InvncibiltyCloak/ESPMaslowController/README.md

# ESPMaslowController
Upgrade of the Maslow CNC controller based on the ESP32 microcontroller.

The design files are for KiCAD.

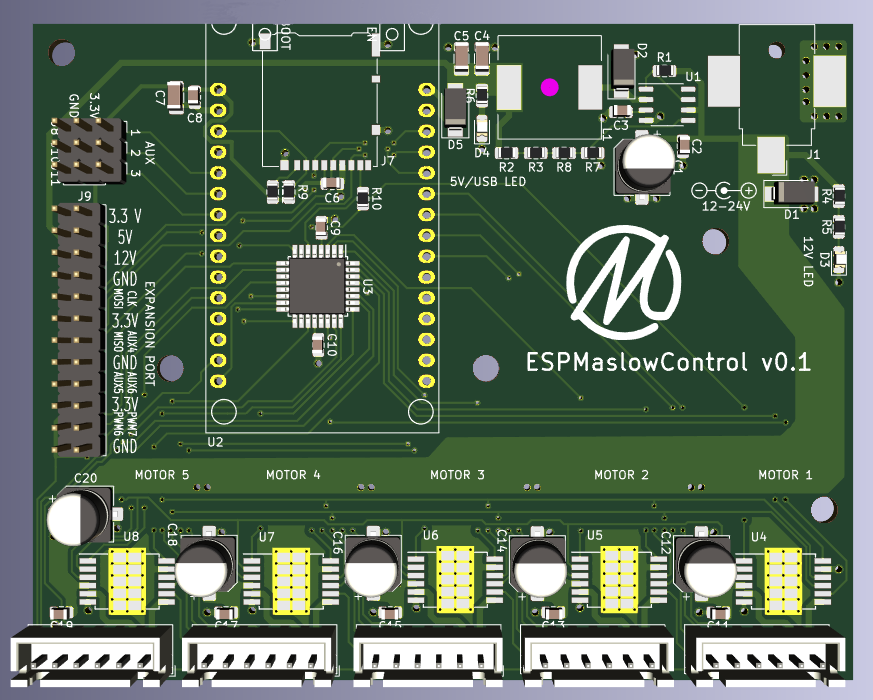
[picture p1: docs/board_render.png]
A rendering of the PCB
