InvncibiltyCloak/ESPMaslowController/ESPMaslowController.pdf

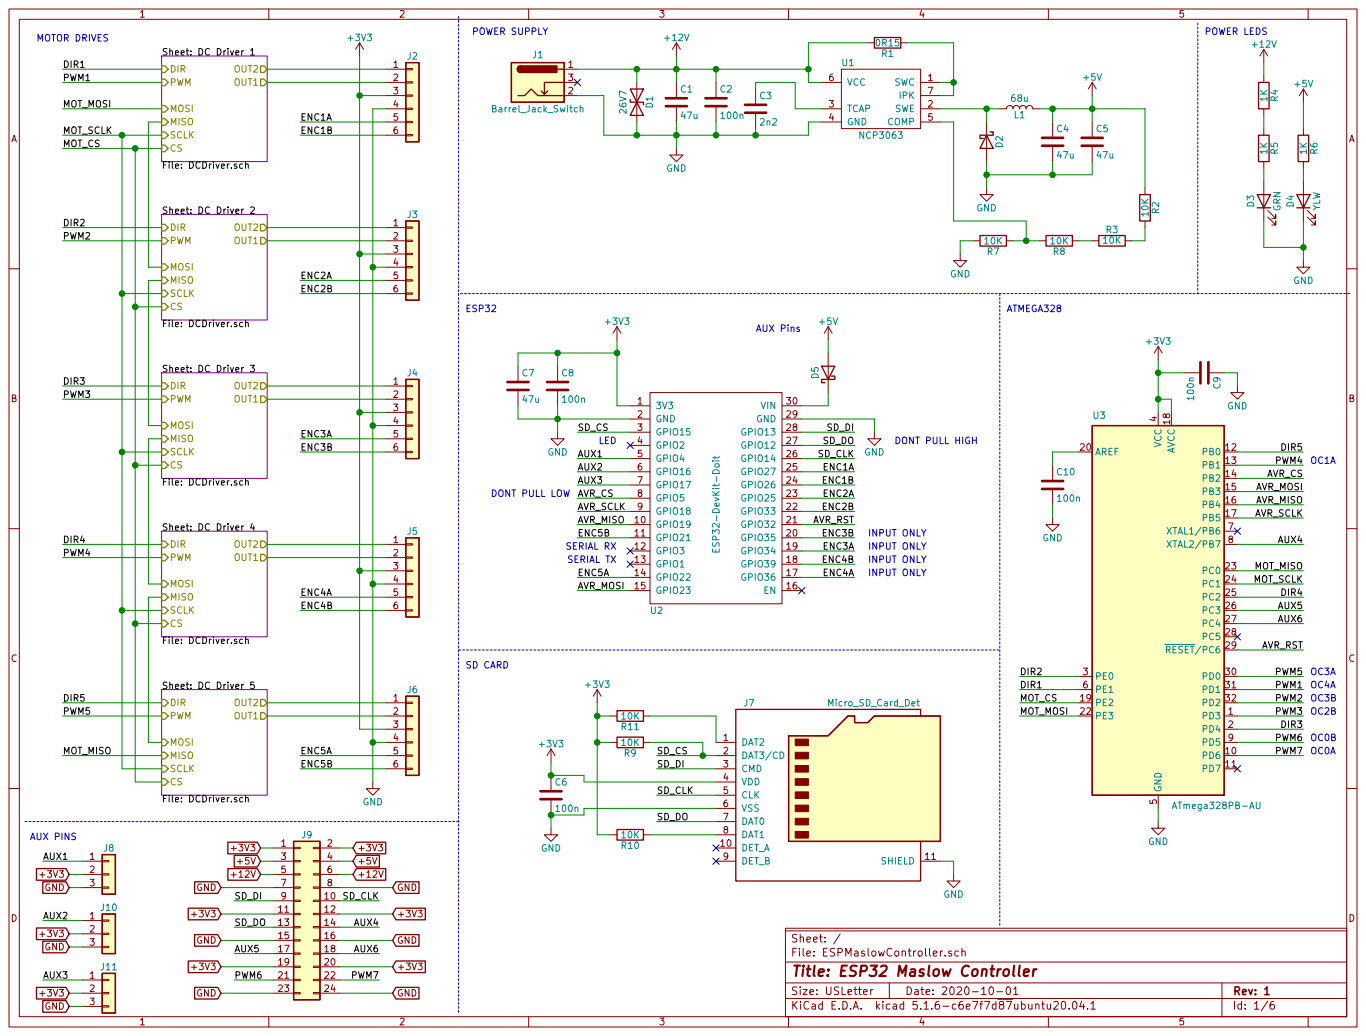
[picture p2: page 1]

Sheet: DC Driver 1 File: DCDriver.sch DIR

Sheet: DC Driver 2 File: DCDriver.sch DIR

Sheet: DC Driver 3 File: DCDriver.sch DIR

INPUT ONLY DONT PULL LOW

Sheet: DC Driver 4 File: DCDriver.sch DIR

Id: 1/6 Title: ESP32 Maslow Controller File: ESPMaslowController.sch Sheet: / Sheet: DC Driver 5 File: DCDriver.sch DIR

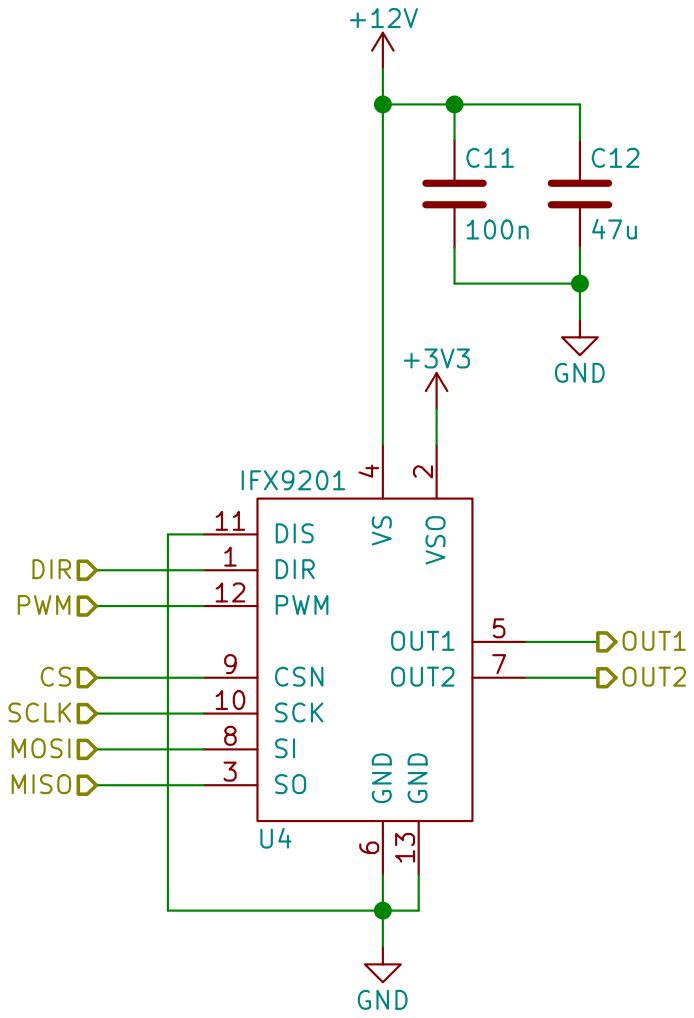
[picture p3: page 2]

Id: 2/6 Title: File: DCDriver.sch Sheet: /DC Driver 1/

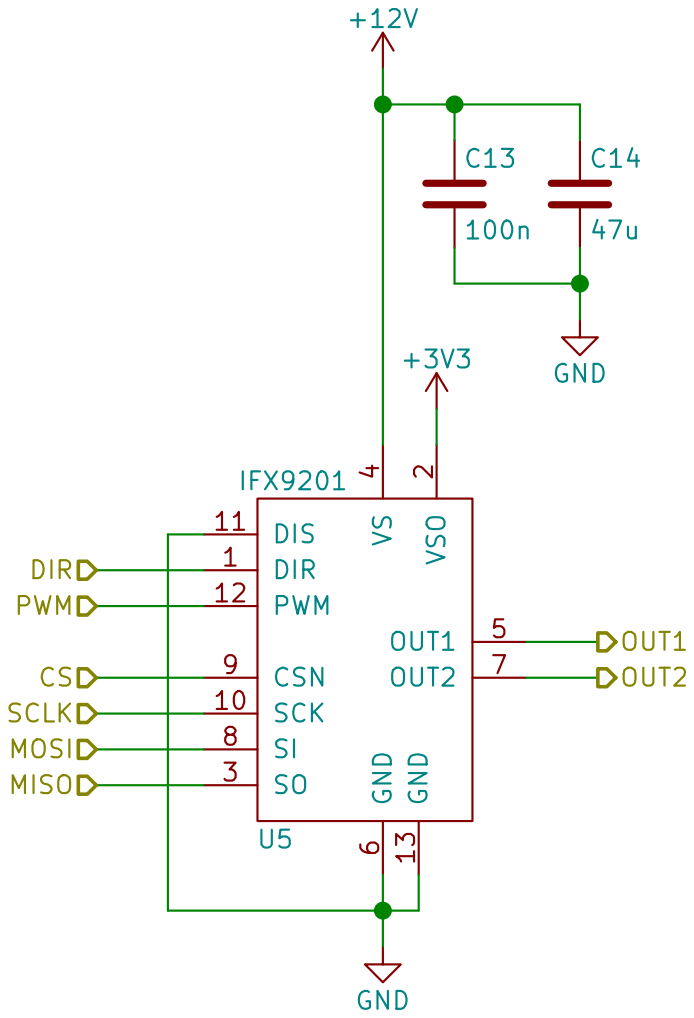
[picture p4: page 3]

Id: 3/6 Title: File: DCDriver.sch Sheet: /DC Driver 2/

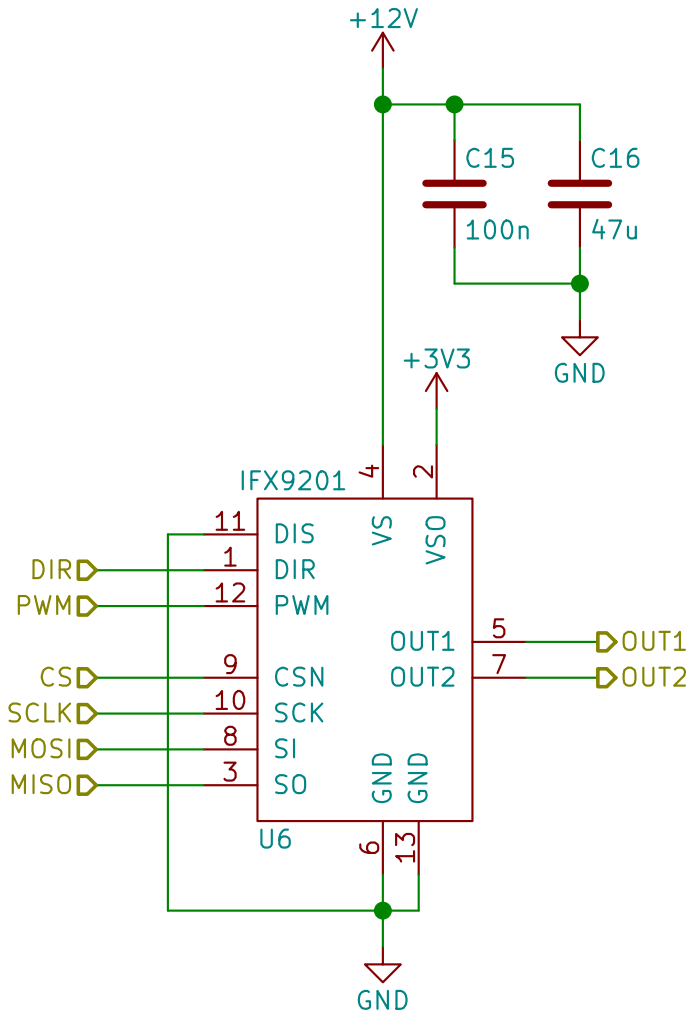
[picture p5: page 4]

Id: 4/6 Title: File: DCDriver.sch Sheet: /DC Driver 3/

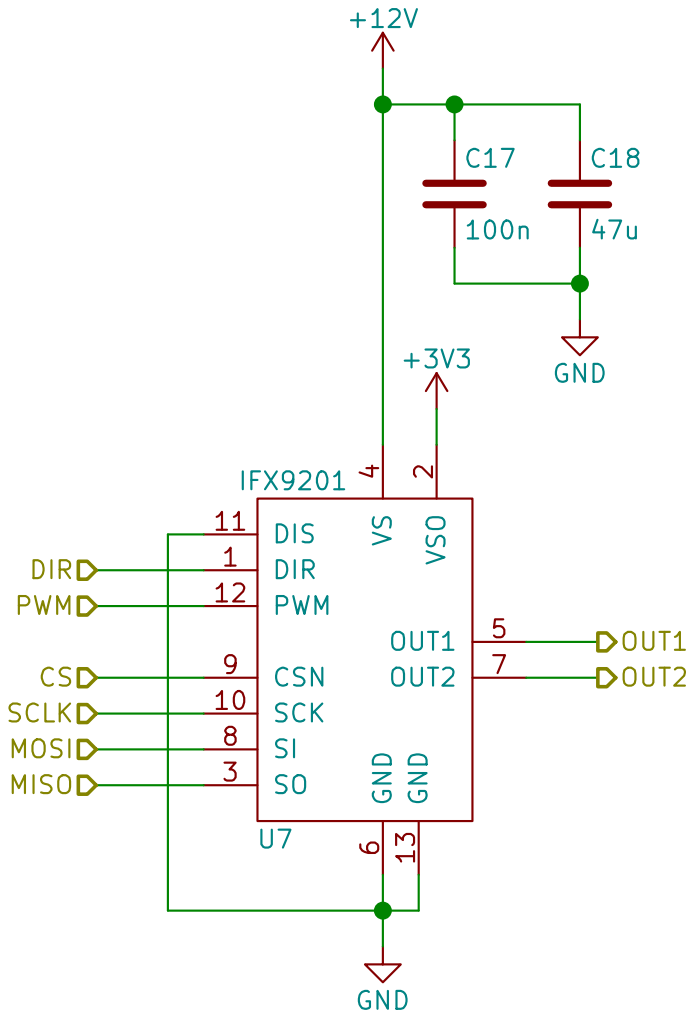
[picture p6: page 5]

Id: 5/6 Title: File: DCDriver.sch Sheet: /DC Driver 4/

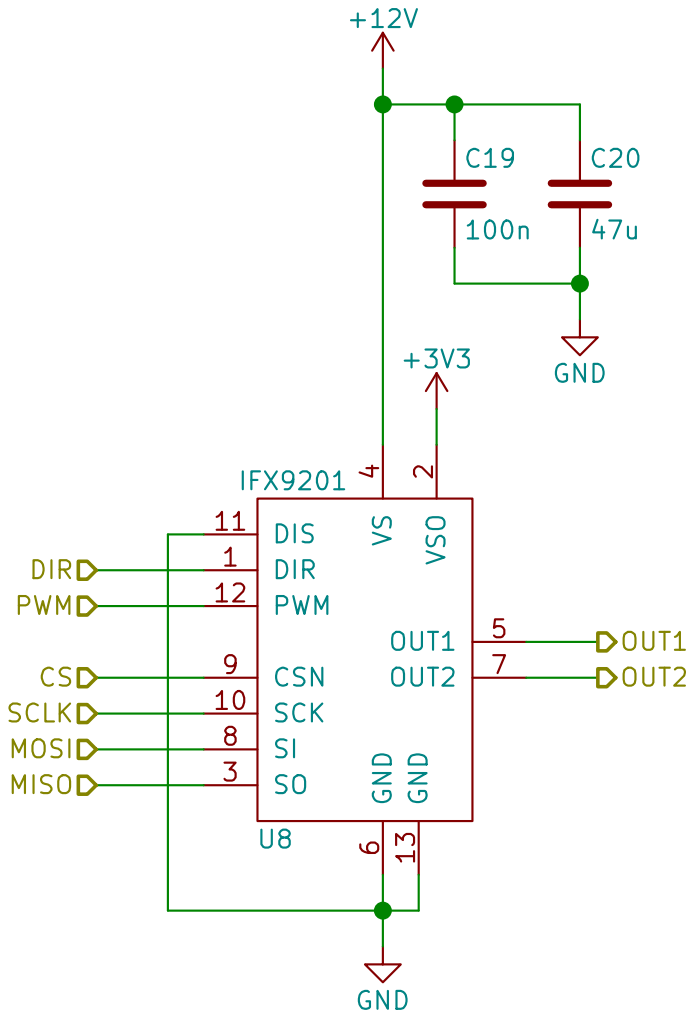
[picture p7: page 6]

Id: 6/6 Title: File: DCDriver.sch Sheet: /DC Driver 5/
