InvncibiltyCloak/ESPMaslowController/ESPMaslowController.kicad_pcb

## KiCad design ESPMaslowController.kicad_pcb (2020-12-19)

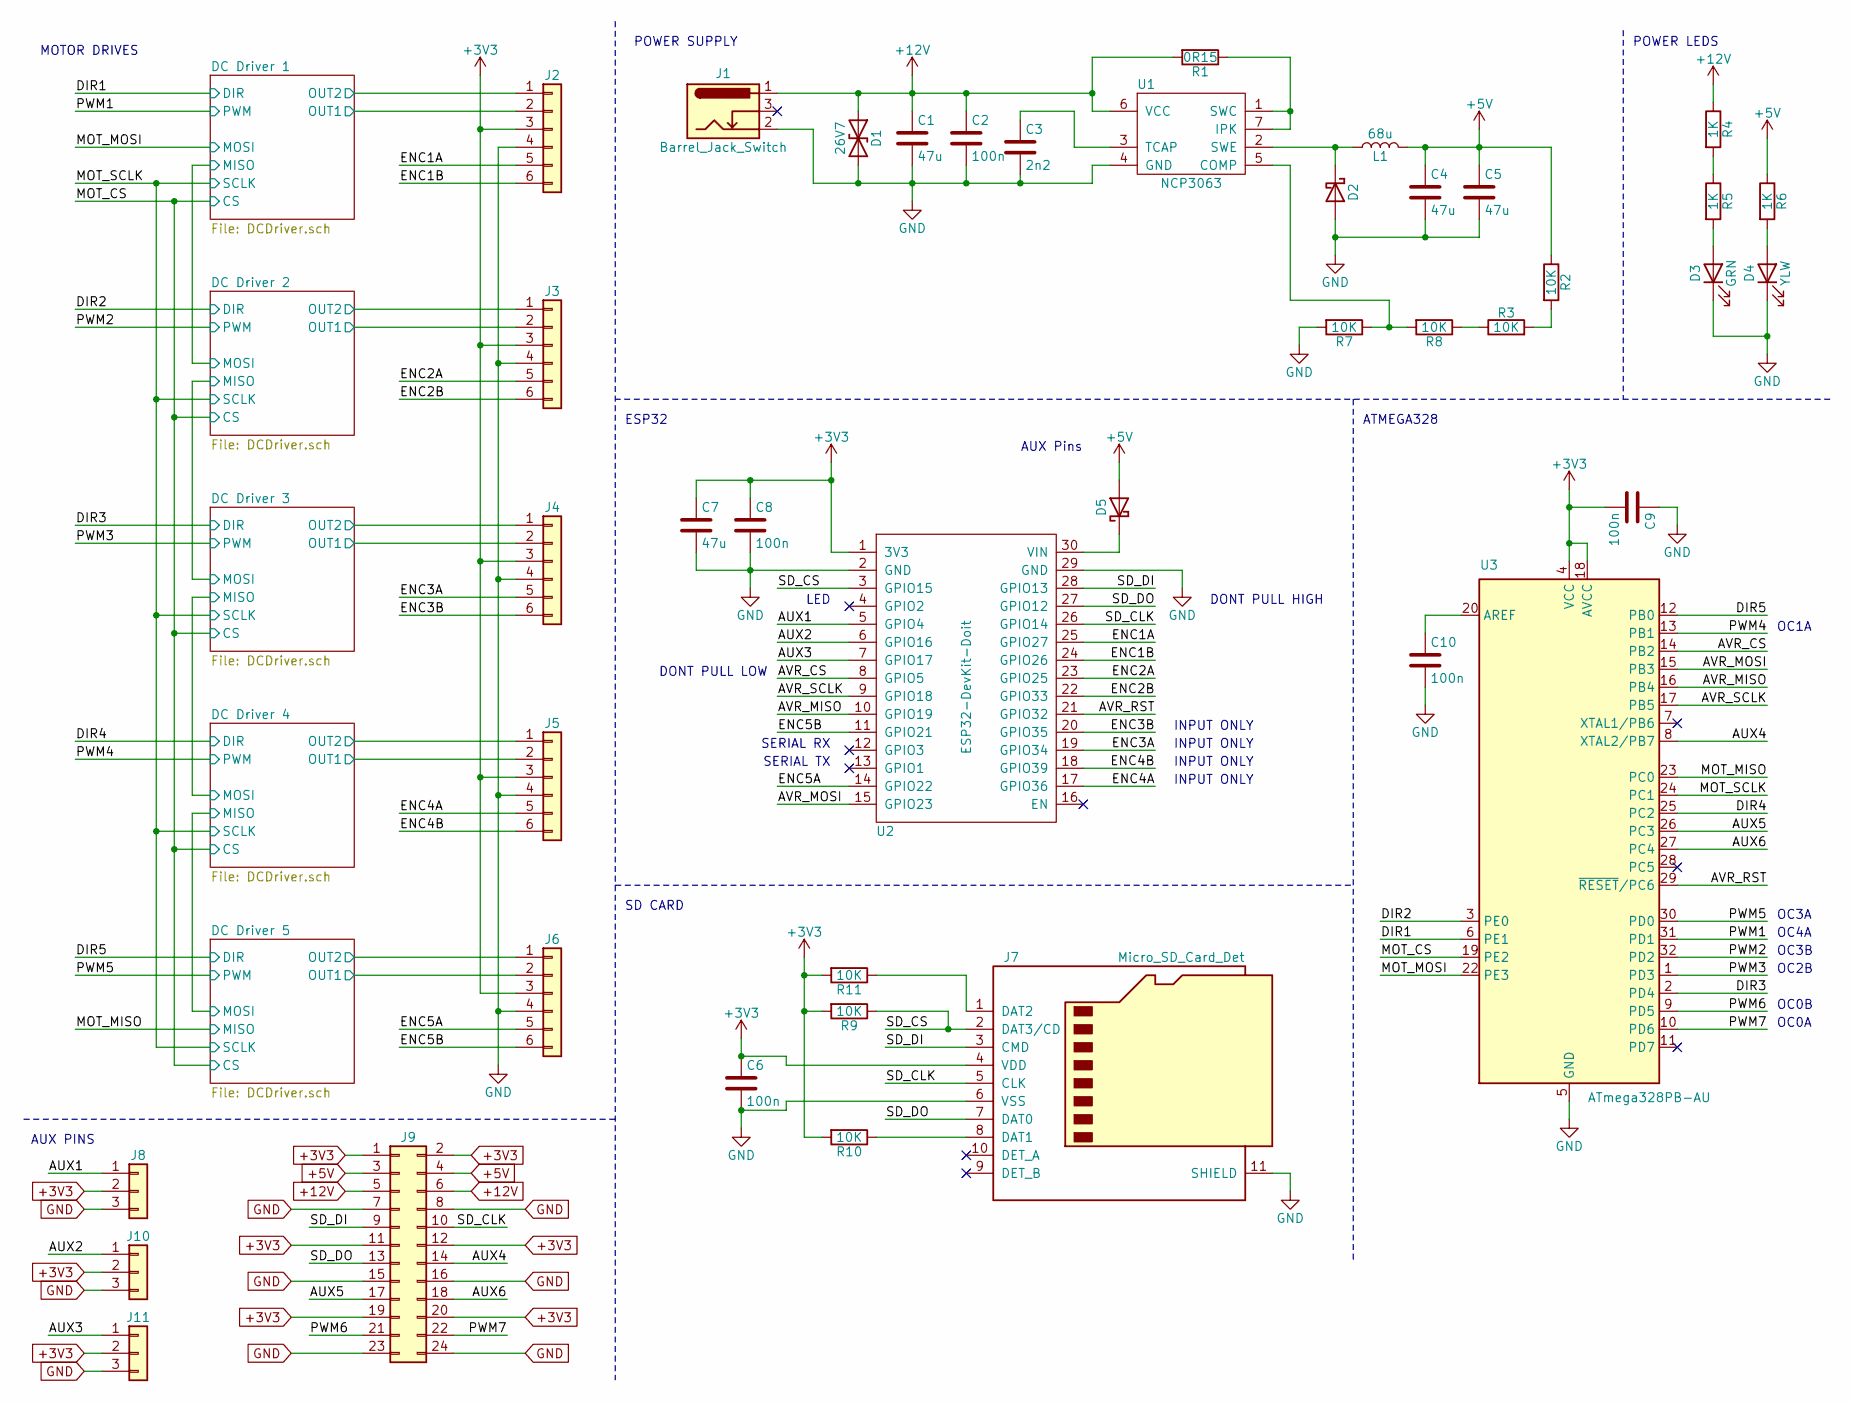
[picture p8: schematic ESPMaslowController.sch, ESP32 Maslow Controller]

Parts:
C1: 47u; CP_Elec_6.3x5.9; MPN 35SVPK47M
C2, C6, C8, C9, C10: 100n; C_0805_2012Metric; MPN CC0805KRX7R9BB104; LCSC C49678
C3: 2n2; C_0805_2012Metric; MPN CL21B222KBANNNC; LCSC C28260
C4, C5, C7: 47u; C_1206_3216Metric; MPN CL31A476MQHNNNE; LCSC C96123
D1: 26V7; D_SMA; MPN SMAJ24CA
D2, D5: 2A; D_SMA; MPN STPS2L30A
D3: GRN; LED_0805_2012Metric_Castellated; MPN LTST-C170KGKT; LCSC C2297
D4: YLW; LED_0805_2012Metric_Castellated; MPN LTST-C171KSKT; LCSC C2296
J1: Barrel_Jack_Switch; BarrelJack_CUI_PJ-036AH-SMT_Horizontal; MPN PJ-036AH-SMT-TR
J2, J3, J4, J5, J6: B6B-XH-A; JST_XH_B6B-XH-A_1x06_P2.50mm_Vertical; MPN B6B-PH-K-S(LF)(SN)
J7: Micro_SD_Card_Det; microSD_HC_Hirose_DM3AT-SF-PEJM5; MPN DM3AT-SF-PEJM5
J8, J10, J11: Conn_01x03; PinHeader_1x03_P2.54mm_Vertical; MPN G800W305018EU
J9: Conn_02x12_Odd_Even; PinHeader_2x12_P2.54mm_Vertical; MPN G800W590018EU
L1: 68u; L_12x12mm_H8mm; MPN NS12575T680MN
R1: 0R15; R_0805_2012Metric; MPN KDV08FR150ET
R2, R3, R7, R8, R9, R10, R11: 10K; R_0805_2012Metric; MPN RC0805FR-0710KL; LCSC C17414
R4, R5, R6: 1K; R_0805_2012Metric; MPN RC0805FR-071KL; LCSC C17513
U1: NCP3063; SO-8_3.9x4.9mm_P1.27mm; MPN NCP3063BDR2G
U2: ESP32-DevKit-Doit; ESP32-DEVKIT-V1; MPN ESP32 DevKit v1
U3: ATmega328PB-AU; TQFP-32_7x7mm_P0.8mm; MPN ATMEGA328PB-AU

Connections:
+3V3: C6.1, C7.1, C8.1, C9.2, J2.3, J3.3, J4.3, J5.3, J6.3, J7.4 (VDD), J8.2, J9.1, J9.2, J9.11, J9.12, J9.19, J9.20, J10.2, J11.2, R9.2, R10.2, R11.2, U2.1 (3V3), U3.4 (VCC), U3.18 (AVCC); also elsewhere on the board
+5V: C4.1, C5.1, D5.2 (A), J9.3, J9.4, L1.1, R2.1, R6.1
+12V: C1.1, C2.1, D1.1 (A1), J1.1, J9.5, J9.6, R1.2, R4.1, U1.6 (VCC); also elsewhere on the board
/AUX1: J8.1, U2.5 (GPIO4)
/AUX2: J10.1, U2.6 (GPIO16)
/AUX3: J11.1, U2.7 (GPIO17)
/AUX4: J9.14, U3.8 (XTAL2/PB7)
/AUX5: J9.17, U3.26 (PC3)
/AUX6: J9.18, U3.27 (PC4)
/AVR_CS: U2.8 (GPIO5), U3.14 (PB2)
/AVR_MISO: U2.10 (GPIO19), U3.16 (PB4)
/AVR_MOSI: U2.15 (GPIO23), U3.15 (PB3)
/AVR_RST: U2.21 (GPIO32), U3.29 (~RESET~/PC6)
/AVR_SCLK: U2.9 (GPIO18), U3.17 (PB5)
/DC Driver 1/OUT1: J2.2; also elsewhere on the board
/DC Driver 1/OUT2: J2.1; also elsewhere on the board
/DC Driver 2/OUT1: J3.2; also elsewhere on the board
/DC Driver 2/OUT2: J3.1; also elsewhere on the board
/DC Driver 3/OUT1: J4.2; also elsewhere on the board
/DC Driver 3/OUT2: J4.1; also elsewhere on the board
/DC Driver 4/OUT1: J5.2; also elsewhere on the board
/DC Driver 4/OUT2: J5.1; also elsewhere on the board
/DC Driver 5/OUT1: J6.2; also elsewhere on the board
/DC Driver 5/OUT2: J6.1; also elsewhere on the board
/DIR1: U3.6 (PE1); also elsewhere on the board
/DIR2: U3.3 (PE0); also elsewhere on the board
/DIR3: U3.2 (PD4); also elsewhere on the board
/DIR4: U3.25 (PC2); also elsewhere on the board
/DIR5: U3.12 (PB0); also elsewhere on the board
/ENC1A: J2.5, U2.25 (GPIO27)
/ENC1B: J2.6, U2.24 (GPIO26)
/ENC2A: J3.5, U2.23 (GPIO25)
/ENC2B: J3.6, U2.22 (GPIO33)
/ENC3A: J4.5, U2.19 (GPIO34)
/ENC3B: J4.6, U2.20 (GPIO35)
/ENC4A: J5.5, U2.17 (GPIO36)
/ENC4B: J5.6, U2.18 (GPIO39)
/ENC5A: J6.5, U2.14 (GPIO22)
/ENC5B: J6.6, U2.11 (GPIO21)
/MOT_CS: U3.19 (PE2); also elsewhere on the board
/MOT_MISO: U3.23 (PC0); also elsewhere on the board
/MOT_MOSI: U3.22 (PE3); also elsewhere on the board
/MOT_SCLK: U3.24 (PC1); also elsewhere on the board
/PWM1: U3.31 (PD1); also elsewhere on the board
/PWM2: U3.32 (PD2); also elsewhere on the board
/PWM3: U3.1 (PD3); also elsewhere on the board
/PWM4: U3.13 (PB1); also elsewhere on the board
/PWM5: U3.30 (PD0); also elsewhere on the board
/PWM6: J9.21, U3.9 (PD5)
/PWM7: J9.22, U3.10 (PD6)
/SD_CLK: J7.5 (CLK), J9.10, U2.26 (GPIO14)
/SD_CS: J7.2 (DAT3/CD), R9.1, U2.3 (GPIO15)
/SD_DI: J7.3 (CMD), J9.9, U2.28 (GPIO13)
/SD_DO: J7.7 (DAT0), J9.13, U2.27 (GPIO12)
GND: C1.2, C2.2, C3.2, C4.2, C5.2, C6.2, C7.2, C8.2, C9.1, C10.2, D1.2 (A2), D2.2 (A), D3.1 (K), D4.1 (K), J1.2, J2.4, J3.4, J4.4, J5.4, J6.4, J7.6 (VSS), J7.11 (SHIELD), J8.3, J9.7, J9.8, J9.15, J9.16, J9.23, J9.24, J10.3, J11.3, R7.2, U1.4 (GND), U2.2 (GND), U2.29 (GND), U3.5 (GND), U3.21 (GND); also elsewhere on the board
unnamed: C3.1, U1.3 (TCAP)
unnamed: C10.1, U3.20 (AREF)
unnamed: D2.1 (K), L1.2, U1.2 (SWE)
unnamed: D3.2 (A), R5.2
unnamed: D4.2 (A), R6.2
unnamed: D5.1 (K), U2.30 (VIN)
unnamed: J7.1 (DAT2), R11.1
unnamed: J7.8 (DAT1), R10.1
unnamed: R1.1, U1.1 (SWC), U1.7 (IPK)
unnamed: R2.2, R3.2
unnamed: R3.1, R8.1
unnamed: R4.2, R5.1
unnamed: R7.1, R8.2, U1.5 (COMP)

Notes on the sheet:
AUX Pins
SERIAL TX
DONT PULL LOW
INPUT ONLY
SERIAL RX
LED
DONT PULL HIGH
AUX PINS
MOTOR DRIVES
POWER SUPPLY
POWER LEDS
ESP32
ATMEGA328
SD CARD
OC2B
OC0B
OC0A
OC1A
OC3A
OC4A
OC3B

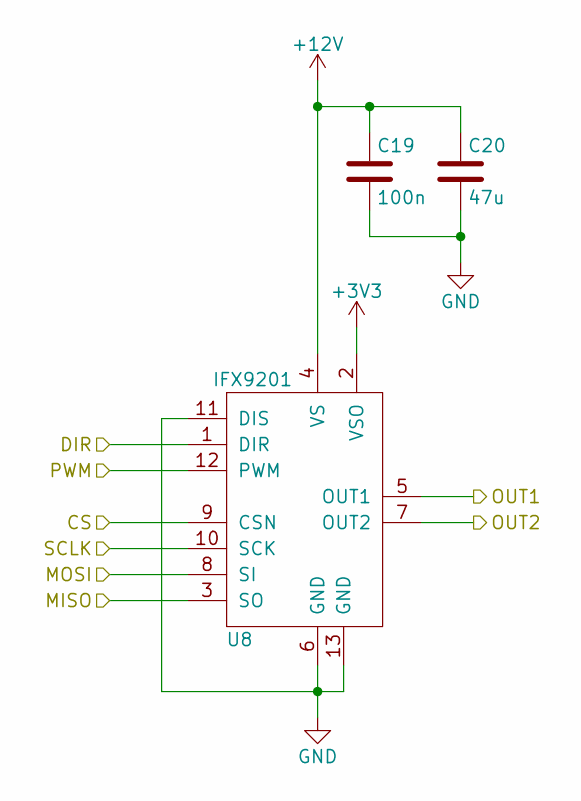
[picture p9: schematic DCDriver.sch]

Parts:
C11: 100n; C_0805_2012Metric; MPN CC0805KRX7R9BB104; LCSC C49678
C12: 47u; CP_Elec_6.3x5.9; MPN 35SVPK47M
U4: IFX9201; Infineon_PG-DSO-12-9_ThermalVias; MPN IFX9201SGAUMA1; LCSC C112633

Connections:
+3V3: U4.2 (VSO); also elsewhere on the board
+12V: C11.1, C12.1, U4.4 (VS); also elsewhere on the board
/DC Driver 1/MISO: U4.3 (SO); also elsewhere on the board
/DC Driver 1/OUT1: U4.5 (OUT1); also elsewhere on the board
/DC Driver 1/OUT2: U4.7 (OUT2); also elsewhere on the board
/DIR1: U4.1 (DIR); also elsewhere on the board
/MOT_CS: U4.9 (CSN); also elsewhere on the board
/MOT_MOSI: U4.8 (SI); also elsewhere on the board
/MOT_SCLK: U4.10 (SCK); also elsewhere on the board
/PWM1: U4.12 (PWM); also elsewhere on the board
GND: C11.2, C12.2, U4.6 (GND), U4.11 (DIS), U4.13 (GND); also elsewhere on the board

Parts of its further copies:
C13, C15, C17, C19: 100n; C_0805_2012Metric; MPN CC0805KRX7R9BB104; LCSC C49678
C14, C16, C18, C20: 47u; CP_Elec_6.3x5.9; MPN 35SVPK47M
U5, U6, U7, U8: IFX9201; Infineon_PG-DSO-12-9_ThermalVias; MPN IFX9201SGAUMA1; LCSC C112633

Connections of its further copies:
+3V3: U5.2 (VSO), U6.2 (VSO), U7.2 (VSO), U8.2 (VSO); also elsewhere on the board
+12V: C13.1, C14.1, C15.1, C16.1, C17.1, C18.1, C19.1, C20.1, U5.4 (VS), U6.4 (VS), U7.4 (VS), U8.4 (VS); also elsewhere on the board
/DC Driver 1/MISO: U5.8 (SI); also elsewhere on the board
/DC Driver 2/MISO: U5.3 (SO), U6.8 (SI)
/DC Driver 2/OUT1: U5.5 (OUT1); also elsewhere on the board
/DC Driver 2/OUT2: U5.7 (OUT2); also elsewhere on the board
/DC Driver 3/MISO: U6.3 (SO), U7.8 (SI)
/DC Driver 3/OUT1: U6.5 (OUT1); also elsewhere on the board
/DC Driver 3/OUT2: U6.7 (OUT2); also elsewhere on the board
/DC Driver 4/MISO: U7.3 (SO), U8.8 (SI)
/DC Driver 4/OUT1: U7.5 (OUT1); also elsewhere on the board
/DC Driver 4/OUT2: U7.7 (OUT2); also elsewhere on the board
/DC Driver 5/OUT1: U8.5 (OUT1); also elsewhere on the board
/DC Driver 5/OUT2: U8.7 (OUT2); also elsewhere on the board
/DIR2: U5.1 (DIR); also elsewhere on the board
/DIR3: U6.1 (DIR); also elsewhere on the board
/DIR4: U7.1 (DIR); also elsewhere on the board
/DIR5: U8.1 (DIR); also elsewhere on the board
/MOT_CS: U5.9 (CSN), U6.9 (CSN), U7.9 (CSN), U8.9 (CSN); also elsewhere on the board
/MOT_MISO: U8.3 (SO); also elsewhere on the board
/MOT_SCLK: U5.10 (SCK), U6.10 (SCK), U7.10 (SCK), U8.10 (SCK); also elsewhere on the board
/PWM2: U5.12 (PWM); also elsewhere on the board
/PWM3: U6.12 (PWM); also elsewhere on the board
/PWM4: U7.12 (PWM); also elsewhere on the board
/PWM5: U8.12 (PWM); also elsewhere on the board
GND: C13.2, C14.2, C15.2, C16.2, C17.2, C18.2, C19.2, C20.2, U5.6 (GND), U5.11 (DIS), U5.13 (GND), U6.6 (GND), U6.11 (DIS), U6.13 (GND), U7.6 (GND), U7.11 (DIS), U7.13 (GND), U8.6 (GND), U8.11 (DIS), U8.13 (GND); also elsewhere on the board

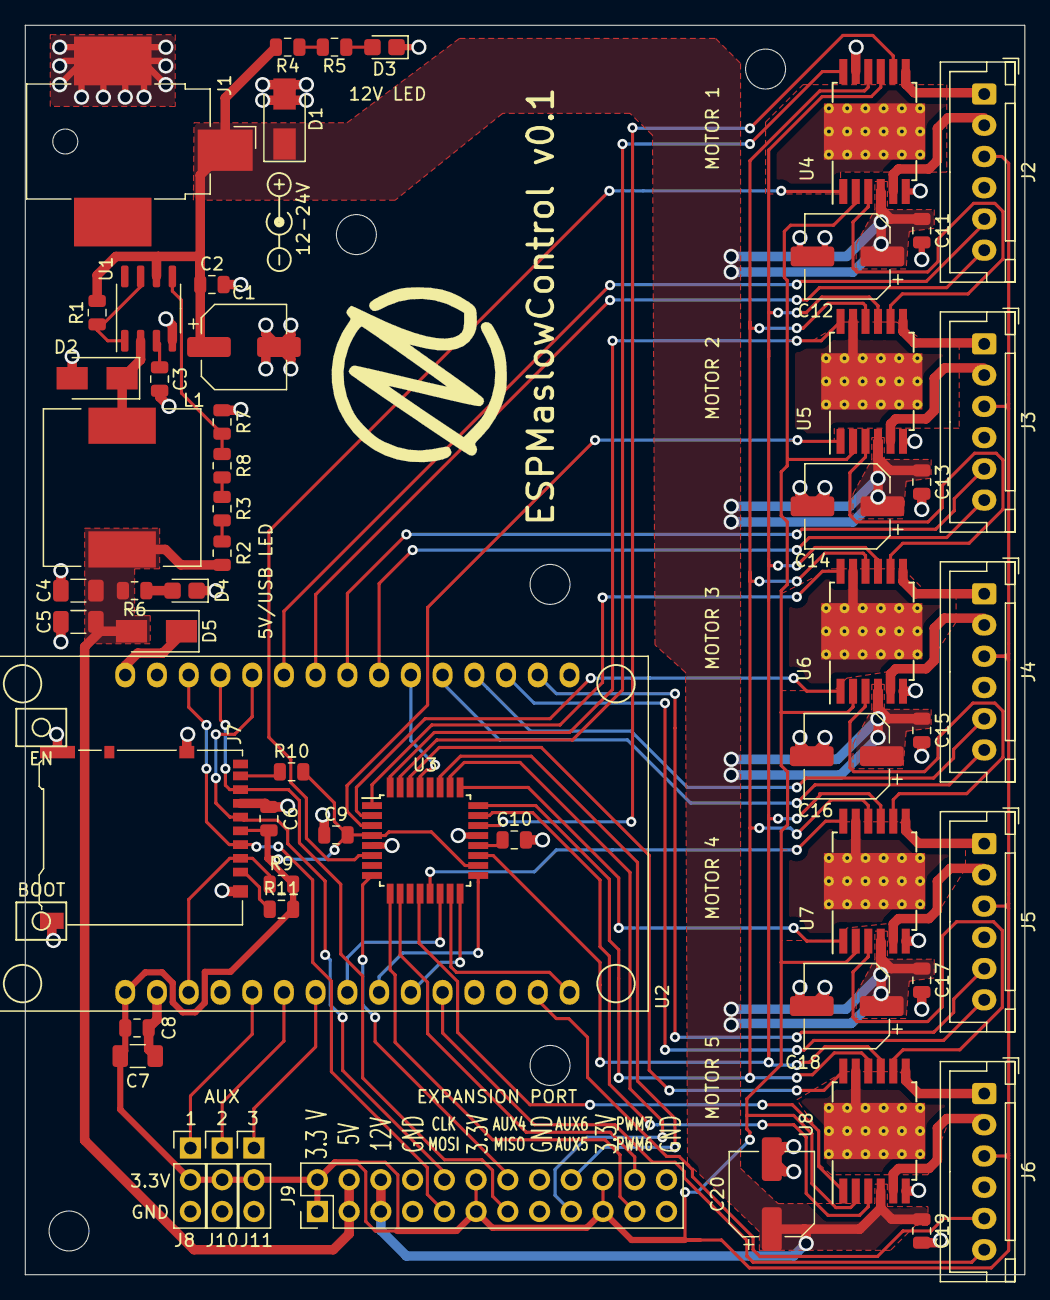
[picture p10: board ESPMaslowController.kicad_pcb from above]

Board: 2 copper layers, 80.0 x 100.0 mm, 56 parts (0 on the bottom side), 72 nets.
