InvncibiltyCloak/ESPMaslowController/(commit log)

2020-10-02 First revision of schematic complete.
    [DCDriver.sch, ESPMaslowController.sch]
2020-10-03 Moved PWM outputs to OC pins on ATmega328.
    The original plan was to do a software PWM on Port D. Testing showed frequencies of only 450 Hz could be achieved at 100% CPU usage. This is too low to be useful, and was not phase-correct PWM.
    [DCDriver.sch, ESPMaslowController.sch]
2020-10-04 Finalized BOM and reworked AUX pins.
    [DCDriver.sch, ESPMaslowController.sch]
2020-10-04 Created footprint for ESP32.
    [DCDriver.sch, ESPMaslowController.sch]
2020-10-08 Revision v0.1 of PCB fully complete.
    [DCDriver.sch, ESPMaslowController.kicad_pcb, ESPMaslowController.sch]
2020-10-09 Updated LCSC references to match ordered parts.
    [DCDriver.sch, ESPMaslowController.sch]
2020-10-09 Added some part numbers for the pin headers.
    [ESPMaslowController.sch]
2020-10-09 Added a BOM to the project for easy reference.
    To guarantee the BOM is up-to-date, you can run the BOM generation script in KiCAD, although I will try to keep it up-to-date.
    [ESPMaslowController-BOM.csv]
2020-10-12 Added pullups to unused SD card lines.
    [ESPMaslowController.kicad_pcb, ESPMaslowController.sch]
2020-10-12 Added pullup to SD CS line.
    [ESPMaslowController.kicad_pcb, ESPMaslowController.sch]
2020-12-19 Fixed board errors.
    Corrected motor connectors to be JST XH series (2.5 mm pitch).
    Corrected NCP3063 feedback resistor divider for 5V output.
    [ESPMaslowController.kicad_pcb, ESPMaslowController.sch]
2020-12-19 Updated README to have board render
